rbakx/DFRobot/DFRobotInside.jpg

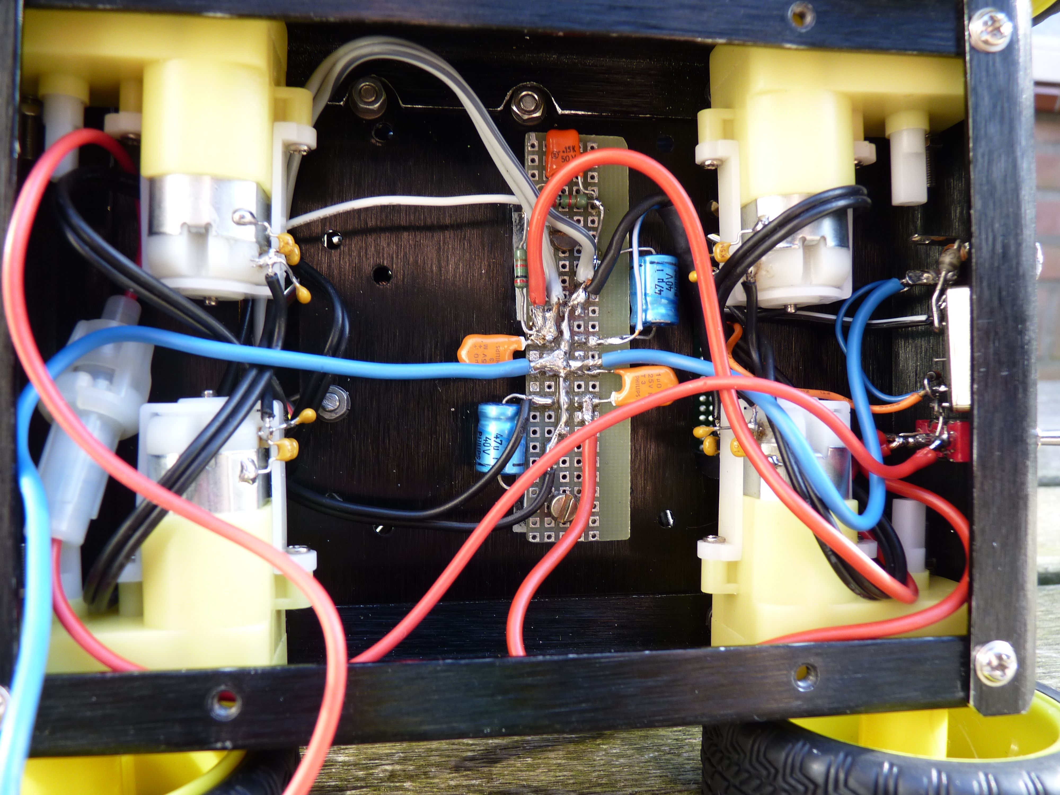
DFRobotInside.jpg
