rbakx/DFRobot/DFRobotProfilePicture.jpg

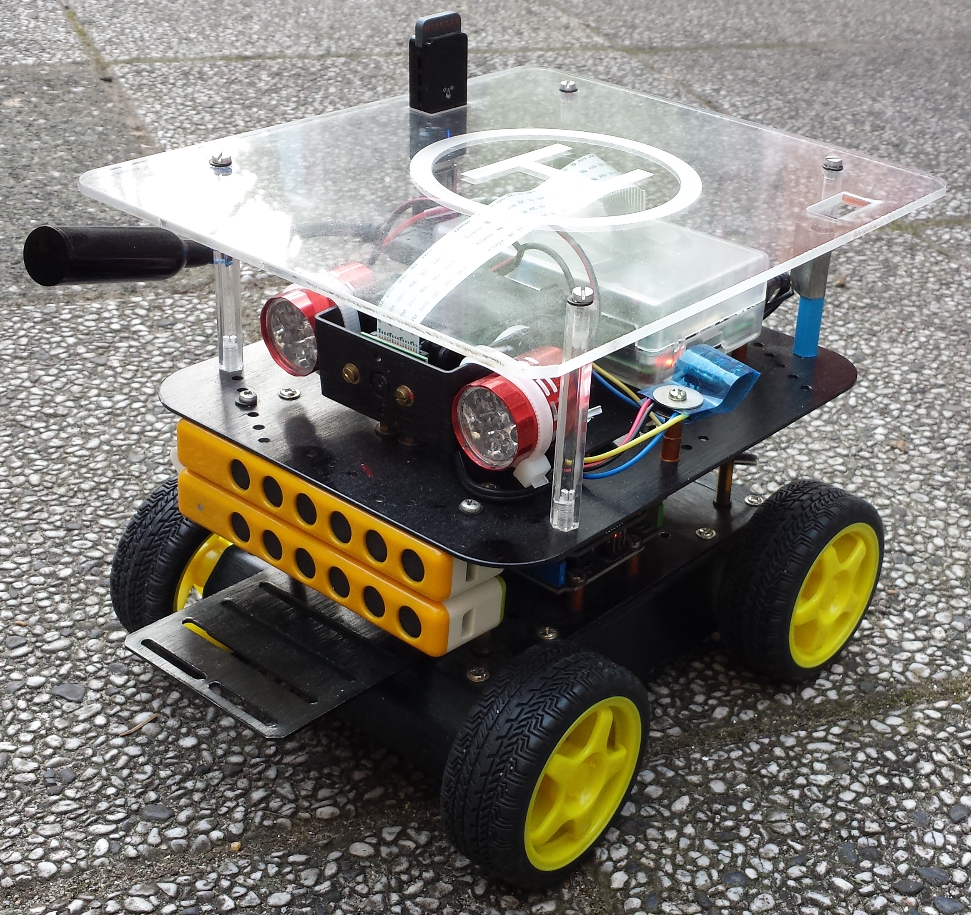
DFRobotProfilePicture.jpg
