rbakx/DFRobot/dfrobot_bw.jpg

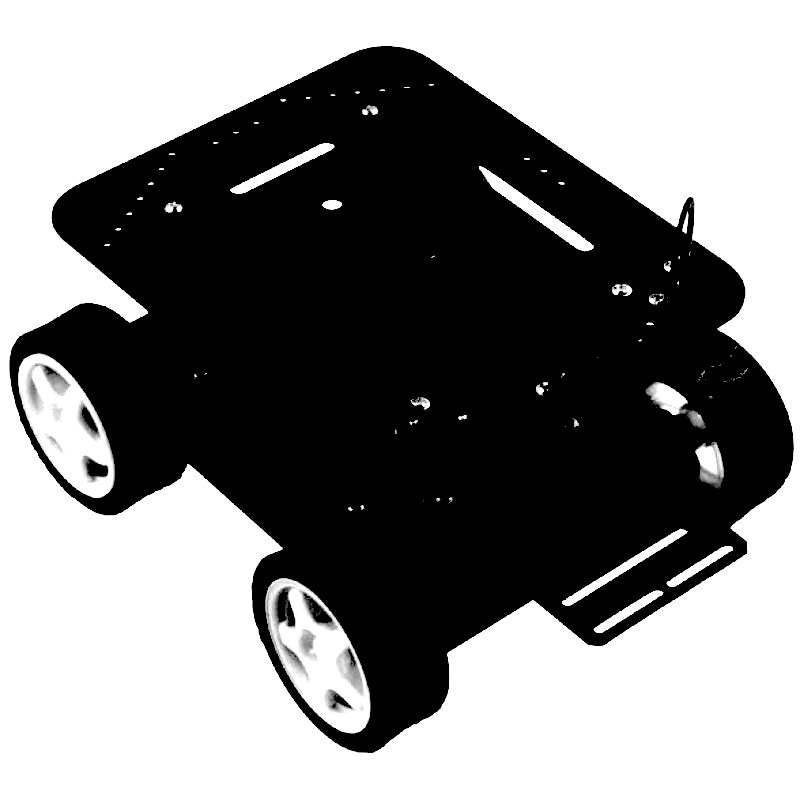
dfrobot_bw.jpg
