rbakx/DFRobot/DFRobotCircuit.png

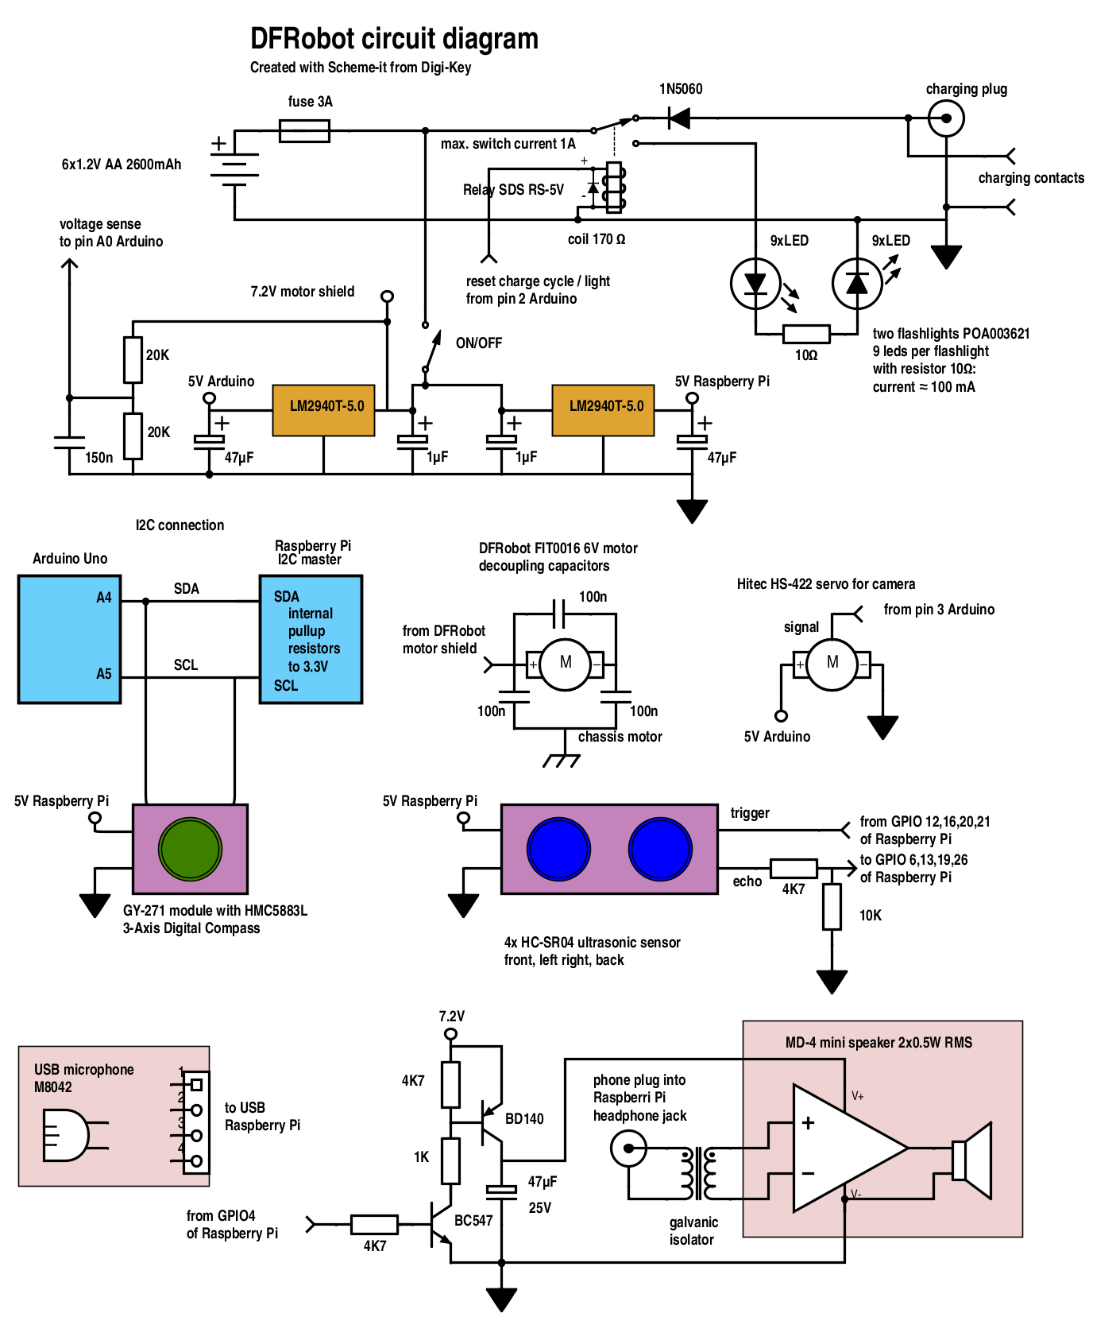
DFRobotCircuit.png
