rbakx/DFRobot/Pi/www/images/DFRobot_org.jpg

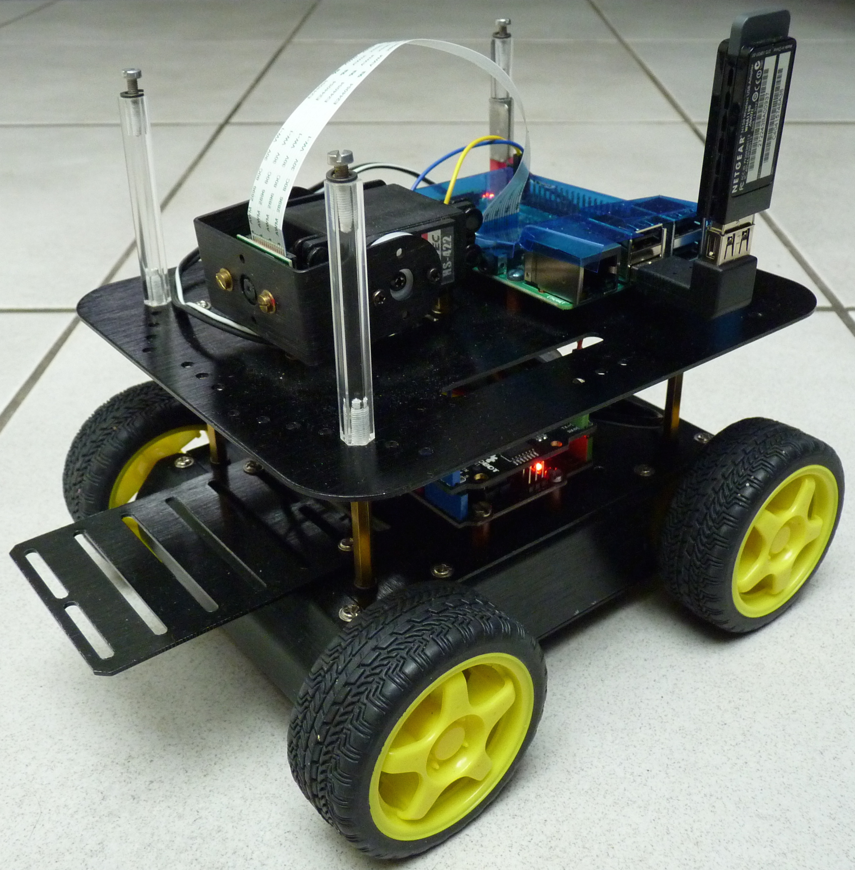
Pi/www/images/DFRobot_org.jpg
