rbakx/DFRobot/Pi/local_bin/own_util.py

#!/usr/bin/python
import time
import math
import os
import subprocess
import thread
import re
import inspect
import logging
import numpy as np
import i2c
import own_gpio


# Global variables.
slaveAddressArduino = 0x04
globUptime = 0
globExtPowerAvailable = False
globIntPowerLevel = 0
globIsCharging = False
globWifiLevel = 0
globDistance = 1000
globDoHomeRun = False
globStop = False


# runShellCommandWait(cmd) will block until 'cmd' is finished.
# This because the communicate() method is used to communicate to interact with the process through the redirected pipes.
def runShellCommandWait(cmd):
    return subprocess.Popen(cmd, stdout=subprocess.PIPE, stderr=subprocess.STDOUT, shell=True).communicate()[0]


# runShellCommandNowait(cmd) will not block because the communicate() method is not used.
# Therefore do not use 'stdout=subprocess.PIPE, stderr=subprocess.STDOUT' here as these pipes will not be read or written
# which means the process can block after a while. This happens for example when running mplayer with runShellCommandNowait().
# Therefore redirection of stdout and stderr to /dev/null is used.
def runShellCommandNowait(cmd):
    subprocess.Popen(cmd + '>/dev/null 2>&1', shell=True)


def getNofConnections():
    # Port 44444 is the main html page and port 44445 is the video stream.
    stdOutAndErr = runShellCommandWait('netstat -an | grep -E \'44444.*ESTABLISHED|44445.*ESTABLISHED\' | wc -l')
    return int(stdOutAndErr)


def isMicFree():
    # Port 44446 is the audio stream.
    stdOutAndErr = runShellCommandWait('netstat -an | grep -E \'44446.*ESTABLISHED\' | wc -l')
    if int(stdOutAndErr) == 0:
        return True
    else:
        return False


# Reboot the system.
def ownReboot(reason):
    logging.getLogger("MyLog").info('going to reboot, reason: ' + reason)
    runShellCommandNowait('sudo reboot')


# Move for a short distance. Used for safe remote control.
def move(direction, delayMove, delayAfterMove, doMove):
    if doMove:
        if direction == 'forward':
            driveAndTurn(63, 0, delayMove, 0, delayAfterMove, doMove)
        elif direction == 'backward':
            driveAndTurn(-63, 0, delayMove, 0, delayAfterMove, doMove)
        elif direction == 'left':
            driveAndTurn(0, -63, 0, delayMove, delayAfterMove, doMove)
        elif direction == 'right':
            driveAndTurn(0, 63, 0, delayMove, delayAfterMove, doMove)


# The driveAndTurn() function lets the robot drive and turn temporary or infinitely.
# When speedTurn != 0 it first drives and turns for the specified delay an then continues driving straight ahead for the specified delay.
# When speedTurn == 0 it only drives straight ahead for the specified delay.
# speedStraight: [-63..63], where [-63..-1] means backward, 0 means zero speed and [1..63] means forward.
# speedTurn:     [-63..63], where [-63..-1] means left, 0 means straight forward and [1..63] means right.
# delayDrive: [0..127], where 0 means infinite, 1 means 50 ms and 127 means 1000 ms.
# delayTurn:  [0..127], where 0 means infinite, 1 means 50 ms and 127 means 1000 ms.
# delayAfterMove is used in autonomous mode to synchronize the python script with the movements and camera stabilization of the robot.
# doMove: False to disable the actual move, for testing purposes.
def driveAndTurn(speedStraight, speedTurn, delayDrive, delayTurn, delayAfterMove, doMove):
    if doMove:
        # Create i2c lock if it does not exist yet.
        i2c.createI2cLock()
        # Lock i2c communication for this thread.
        i2c.globI2cLock.acquire()
        # I2C command 1.
        i2c.write_byte(slaveAddressArduino, 0, 1)
        # Because the I2C parameters are in the range of [128..255], speed range [-63..63] is mapped to [129..255].
        # Start with 129 to keep backward / forward or left / right symmetry around 192.
        i2c.write_byte(slaveAddressArduino, 0, int(speedStraight) + 192)
        i2c.write_byte(slaveAddressArduino, 0, int(speedTurn) + 192)
        # Because the I2C parameters are in the range of [128..255], delay range [0..127] is mapped to [128..255].
        i2c.write_byte(slaveAddressArduino, 0, int(delayDrive) + 128)
        i2c.write_byte(slaveAddressArduino, 0, int(delayTurn) + 128)
        # Delay for i2c communication.
        time.sleep(i2c.globI2cDelay)
        # Release i2c communication for this thread.
        i2c.globI2cLock.release()
    # Still delay when doMove == False to have similar timing.
    time.sleep(delayAfterMove)


def moveCamRel(degrees, delay):
    if degrees >= -90 and degrees <= 90:
        if degrees > 0:
            # Create i2c lock if it does not exist yet.
            i2c.createI2cLock()
            # Lock i2c communication for this thread.
            i2c.globI2cLock.acquire()
            # I2C command 10.
            i2c.write_byte(slaveAddressArduino, 0, 10)
            i2c.write_byte(slaveAddressArduino, 0, 128 + int(degrees))
            # Delay for i2c communication.
            time.sleep(i2c.globI2cDelay)
            # Release i2c communication for this thread.
            i2c.globI2cLock.release()
        elif degrees < 0:
            # Create i2c lock if it does not exist yet.
            i2c.createI2cLock()
            # Lock i2c communication for this thread.
            i2c.globI2cLock.acquire()
            # I2C command 11.
            i2c.write_byte(slaveAddressArduino, 0, 11)
            i2c.write_byte(slaveAddressArduino, 0, 128 - int(degrees))
            # Delay for i2c communication.
            time.sleep(i2c.globI2cDelay)
            # Release i2c communication for this thread.
            i2c.globI2cLock.release()
        # Delay to let camera image stabilize.
        time.sleep(delay)


def moveCamAbs(degrees, delay):
    if degrees >= 0 and degrees <= 90:
        # Create i2c lock if it does not exist yet.
        i2c.createI2cLock()
        # Lock i2c communication for this thread.
        i2c.globI2cLock.acquire()
        # I2C command 12.
        i2c.write_byte(slaveAddressArduino, 0, 12)
        i2c.write_byte(slaveAddressArduino, 0, 128 + int(degrees))
        # Delay for i2c communication.
        time.sleep(i2c.globI2cDelay)
        # Release i2c communication for this thread.
        i2c.globI2cLock.release()
        # Delay to let camera image stabilize.
        time.sleep(delay)


def switchLight(on):
    if on == True:
        # Create i2c lock if it does not exist yet.
        i2c.createI2cLock()
        # Lock i2c communication for this thread.
        i2c.globI2cLock.acquire()
        # I2C command 20.
        i2c.write_byte(slaveAddressArduino, 0, 20)
        # Delay for i2c communication.
        time.sleep(i2c.globI2cDelay)
        # Release i2c communication for this thread.
        i2c.globI2cLock.release()
    else:
        # Create i2c lock if it does not exist yet.
        i2c.createI2cLock()
        # Lock i2c communication for this thread.
        i2c.globI2cLock.acquire()
        # I2C command 21.
        i2c.write_byte(slaveAddressArduino, 0, 21)
        # Delay for i2c communication.
        time.sleep(i2c.globI2cDelay)
        # Release i2c communication for this thread.
        i2c.globI2cLock.release()


def updatePowerInfo():
    global globExtPowerAvailable, globIntPowerLevel
    # Create i2c lock if it does not exist yet.
    i2c.createI2cLock()
    # Lock i2c communication for this thread.
    i2c.globI2cLock.acquire()
    # Going to read I2C data.
    # Read external power level. If the level > 100, we assume external power is available.
    i2c.write_byte(slaveAddressArduino, 0, 100)  # Command to indicate a read is going to follow.
    i2c.write_byte(slaveAddressArduino, 0, 128)  # 128 means read external power level.
    if i2c.read_byte(slaveAddressArduino, 0) > 100:
        globExtPowerAvailable = True
    else:
        globExtPowerAvailable = False
    # Delay before retrieving the next power info.
    time.sleep(i2c.globI2cDelay)
    # Read internal power level. This power level can be from external power or the batteries.
    i2c.write_byte(slaveAddressArduino, 0, 100)  # Command to indicate a read is going to follow.
    i2c.write_byte(slaveAddressArduino, 0, 129)  # 129 means read internal power level.
    globIntPowerLevel = i2c.read_byte(slaveAddressArduino, 0)
    # Delay for i2c communication.
    time.sleep(i2c.globI2cDelay)
    # Release i2c communication for this thread.
    i2c.globI2cLock.release()


def updateDistanceInfo():
    global globDistance
    distance = own_gpio.getUsSensorDistance(0)
    # distance can be 0 which means invalid. In that case do not update globDistance.
    if (distance != 0):
        globDistance = distance


def updateWifiStatus():
    global globWifiLevel
    stdOutAndErr = runShellCommandWait('/sbin/iwconfig')
    # Use DOTALL (so '.' will also match a newline character) because stdOutAndErr can be multiline.
    expr = re.compile('.*ESSID:"(.*)".*?Signal level=(.*dBm)', re.DOTALL)
    m = expr.match(stdOutAndErr)
    if m is not None:  # m will be not None only when both capture groups are valid.
        globWifiLevel =  m.group(1) + ': ' + m.group(2)
    else:
        globWifiLevel = 'wifi unknown'


def updateUptime():
    global globUptime
    stdOutAndErr = runShellCommandWait('/usr/bin/uptime')
    # Use DOTALL (so '.' will also match a newline character) because stdOutAndErr can be multiline.
    expr = re.compile('.*up ([^,]+).*', re.DOTALL)
    m = expr.match(stdOutAndErr)
    if m is not None:
        globUptime = m.group(1)
    else:
        globUptime = 'unknown'


def uploadAndPurge(filepath, nrOfFilesToKeep):
    # Check if filename starts with 'dfrobot_' and number of files to keep >= 1 else do not purge anything and exit.
    filename = os.path.basename(filepath)
    if filename[:8] != 'dfrobot_' or nrOfFilesToKeep < 1:
        logging.getLogger("MyLog").info('uploadAndPurge: illegal filepath:nrOfFilesToKeep to upload and purge: ' + filepath + ':' + str(nrOfFilesToKeep))
        return
    
    # Going to upload the file to Google Drive using the 'drive' utility.
    # To upload into the 'DFRobotUploads' folder, the -p option is used with the id of this folder.
    # When the 'DFRobotUploads' folder is changed, a new id has to be provided.
    # This id can be obtained using 'drive list -t DFRobotUploads'.
    # The uploaded file has a distinctive name to enable finding and removing it again with the 'drive' utility.
    logging.getLogger("MyLog").info('going to call \'drive\' to upload ' + filepath)
    # Run 'drive' as www-data to prevent Google Drive authentication problems.
    stdOutAndErr = runShellCommandWait('sudo -u www-data /usr/local/bin/drive upload -p 0B1WIoyfCgifmMUwwcXNqeDl6U1k -f ' + filepath)
    logging.getLogger("MyLog").info(stdOutAndErr)

    # Purge filename on Google Drive to prevent filling up.
    logging.getLogger("MyLog").info('going to purge ' + filename)
    # Find all Id's of filename versions on drive.
    stdOutAndErr = runShellCommandWait('sudo -u www-data /usr/local/bin/drive list -t ' + filename)
    # Now stdOutAndErr is a multiline string containing on each line a file version.
    # The last line is the oldest.
    # The first line is the title line so does not contain a valid file version.

    # Use a regular expression to get the file Id's of the oldest files to be purged in a list.
    # Use MULTILINE (so '^' will match the start of a new line) because stdOutAndErr can be multiline.
    expr = re.compile('(^.*?) ', re.MULTILINE)
    idList = expr.findall(stdOutAndErr)
    # Now idList is a list containing the Id's of all file versions.
    # The last Id in the list is the oldest.
    if idList is not None:
        logging.getLogger("MyLog").info('uploadAndPurge: ' + str(len(idList) - 1) + ' versions of ' + filename + ' found on Google Drive')
        # Iterate backwards through the list, starting with the oldest file
        # until there are nrOfFilesToKeep files left.
        for i in range(len(idList)-1, nrOfFilesToKeep, -1):
            # Delete this file version.
            stdOutAndErr = runShellCommandWait('sudo -u www-data /usr/local/bin/drive delete -i ' + idList[i])
            logging.getLogger("MyLog").info(stdOutAndErr)
