rbakx/DFRobot/(commit log)

2015-01-22 Added camera module installation instructions
2015-01-29 Updated Pi camera MJPG streamer instructions
2015-02-03 Added intro to doc and aded vertical flip -vf to camera
2015-02-04 Streaming MJPEG and fixed refresh
    Switched from JavaScript supported MJPEG to browser supported MJPEG,
    which is about 3 times faster.
    Fixed CGI Python refresh issue of webpage.
2015-02-05 switch from Python CGI to bash CGI
    Because Python CGI is very slow (1 to 3 seconds for each POST) I
    switched from Python CGI to bash CGI.
2015-02-06 removed while loop from dfrobot.sh
    Removed the original while loop from dfrobot.sh which was originally
    taken from
    http://tuxx-home.at/cmt.php?article=/2005/06/17/T09_07_39/index.html
    but in this case has no added value.
2015-02-20 Added Arduino code and I2C connection to Pi
    This is the first version of the DFRobot project where the robot can be
    controlled from the webpage: forward, backward, left and right!
2015-02-20 Added battery status and light
2015-02-20 Added sd card mounting instructions
    Added sd card mounting instructions and also added extra Wifi access
    point to allow roaming.
2015-02-21 Added extra status frame and security
    Added extra status html frame to only refresh the status when needed.
    Added Apache password protection of the DFRobot web page.
2015-02-21 changed charge cycle from 6 to 2 hrs
2015-04-08 Updated watchdog info and added circuit diagram
2015-04-19 Added camera servo control up and down
2015-04-19 Updated naming to support multiple servos
2015-04-26 Uodated circuit diagram and bigger status area.
    Updated circuit diagram with charging contacts. Also enlarged status
    area on html page to support more status text.
2015-04-26 Servo for camera to pin 3 and added to drawing
2015-05-03 Added automated uploads to Google Drive and more...
    - Added automated uploads of captured H264 video to Google Drive using
    the ‘drive’ utility.
    - Added purging of these automated video so Google Drive does not fill
    up.
    - Added a runDFRobot script and scheduled it with ‘cron’ to capture
    H264 and upload to Google Drive every hour!
    - When an user is connected to the webwerver the runDFRobot script does
    not initiate any action.
2015-05-14 switched to use of uv4l for video, better support and performance
2015-05-14 changed video framerate from 30 to 10 for better performance when connection is poor
2015-05-14 updated doc for framerate 30 -> 10
2015-05-15 Added low video framerate measurement
2015-07-19 Installed OpenCV from standard package and switched back from UV4L to mjpg-streamer
2015-07-24 Raspberry B+ replaced by Raspberry 2B, increase of openCV screen resolution and added compass script.
    [compass.py]
2015-07-28 Switch from findContours to SimpleBlobDetector 'for better performance (color independent)
2015-07-28 run_dfrobot.py uses blob detector to find back the garage.
    goHomeDFRobot.py and runDFRobot.py are replaced by one script:
    run_dfrobot.py.
    This script can run in the Full run or in the Home run mode.
    It uses cv2.SimpleBlobDetector() to find the garage and connect to the
    charging station.
    [compass.py, dfrobot.ino, own_util.py, run_dfrobot.py]
2015-07-30 updated circuit diagram and added delay in compass.py
2015-07-30 new calibration compass HMC5883L
2015-08-16 Implemented separate video thread and motion detection
2015-08-17 In homerun blob detection skip blobs which are significantly smaller than the other blobs
    [run_dfrobot.py]
2015-08-22 separate thread for WhatsApp client for handling incoming and outgoing messages
    whatsAppClient() is now a separate thread handling incoming and
    outgoing messages.
    Commands can be given via WhatsApp like sending a picture, report
    battery level.
2015-08-22 Replaced own logging by Python logging and solved locking up problems
    [own_util.py, run_dfrobot.py]
2015-08-22 Make use of Python shutil functions and solved potential lock
    [run_dfrobot.py]
2015-08-23 Solved one more locking issue.
    [own_util.py, run_dfrobot.py]
2015-08-23 Added restart of whatsAppClient if needed
    the yowsup-cli seems not very stable, so we catch the exception if the
    stdin pipe to if it is broken (due to a crash of yowsup-cli) and
    restart.
    [own_util.py, run_dfrobot.py]
2015-09-01 WhatsApp message handling is now done in whatsAppClient() instead of in motionDetection()
    WhatsApp message handling is now done in whatsAppClient() instead of in
    motionDetection() because the whatsAppClient() thread always runs.
2015-09-03 Added checkWhatsAppClient() to check and restart whatsAppClient thread if needed
2015-09-08 Fixed validBlobsFound bug and added battery charging status
    [compass.py, own_util.py, run_dfrobot.py]
2015-09-13 Smarter argument parsing and check charging status in whatsApp thread
2015-09-13 reduced number of calibration rounds
2015-09-13 Added offset correction at 180 degrees for the compass
    [compass.py]
2015-09-20 Added socket connection between cgi bash script and python
2015-09-26 Replaced purge_dfrobot_uploads.sh by Python function uploadAndPurge()
    [own_util.py]
2015-09-27 Two way socket communication and no need anymore to check number of connections for detecting webpage activity.
2015-10-18 replaced i2c_cmd by Python script
    [communication.py, compass.py, i2c.py, own_util.py, run_dfrobot.py]
2015-10-20 Adapted circuit diagram to new flashlights wit series resistor.
2015-10-21 Fixed I2C communication problem by adding exception handling
    Occasionally the I2C communication between the Raspberry and the
    Arduino gave a ‘[Errno 5] Input/output error’. This seems to be a known
    problem. Adding exception handling for I2C communication prevents the
    code from crashing.
    [compass.py, i2c.py, own_util.py]
2015-10-21 Added /boot/config.txt with custom i2c settings
    [config.txt]
2015-10-24 Added charging status on website and added SD card images list to DFRobot document
2015-10-30 Fixed WhatsApp authorization error by re-registering and running Yowsup setup.
    [communication.py, run_dfrobot.py]
2015-11-22 Added personal assistant!
    [config.txt]
2015-11-22 name of personal assistant changed from robbie to james
    [communication.py]
2015-11-25 Improved clap detection and automatic switch on lights when dark.
2015-12-02 Improved recognition of alarm voice command, fix of runShellCommandNowait() problem with mplayer
    [own_util.py, personal_assistant.py]
2015-12-12 Added bandpass filter to improve clapping detection and added Ibm speech recognition for when Google is offline
2015-12-12 Improved clap detection by using bandpass filter and added support for IBM Watson and Wit.ai speech engines
2015-12-15 fixed 'list index out of range' problem when there is no speech (silence) sent to Google
    [personal_assistant.py]
2016-01-01 Updated info on Raspberry Pi firmware
2016-01-02 Added more info on Raspberry Pi boot process.
2016-04-27 Bind socket to any host so robot can be controlled by any host.
2016-04-28 Added 'James go home' voice command.
    [personal_assistant.py]
2016-05-01 Socket connection from TCP to UDP, added ultrasonic sensor and Unity support through socket
2016-05-17 Enabled text box command window and added reboot command
    [compass.py, own_util.py, run_dfrobot.py]
2016-07-30 More robust reboot and added 'whatsapp' command to restart WhatsApp
    • Moved handling of ‘reboot’ command from run_dfrobot.py to dfrobot.sh
    to make sure it is executed; other threads might be corrupt.
    • Fixed ‘globBrightness’ bug in run_dfrobot.py so lights are not always
    switched on after the ‘home-start’ command.
    • Added 3 seconds delay in ‘startWhatsAppClient()’ to make sure
    WhatsApp connects after a reboot.
    • Added ‘whatsapp’ command to restart WhatsApp if needed.
    [communication.py, run_dfrobot.py]
2016-09-18 Replaced WhatsApp by Telegram.
    • Run of sudo apt-get update and sudo apt-get upgrade to upgrade all
    installed Wheezy packages.
    • Cleaned downloaded packages with sudo apt-get clean.
    • Replaced WhatsApp by Telegram.
    • Upload to Google Drive commented out and replaced by sending to
    Telegram.
    [communication.py, run_dfrobot.py]
2016-11-26 Added Mic button on webpage to start streaming
2016-11-26 Simpler audio streaming switching and 16 KHz
2017-05-22 Fixed driving and turning in FPV mode
    [communication.py, dfrobot.ino, own_util.py, run_dfrobot.py]
2017-05-28 Replaced CGI by websocket communication
    [communication.py, compass.py, own_util.py, personal_assistant.py, run_dfrobot.py]
2017-07-03 updated mjpg-streamer to solve broken pipe issues
    [communication.py, run_dfrobot.py]
2017-07-16 Moved back to Pi camera and added external power switch
    • Reverted back to use of Raspberry Pi camera as the PU` Aimetis Dual
    Lens USB Camera is broken.
    • Added switching to external power when it is available. This is done
    using a relay. Switching from batteries to external power is when the
    robot is in the garage and only when the external power is stable.
    Switching from external power to batteries is done just before the
    robot starts driving out of the garage. This because during the power
    switch the robot is powered only by a capacitor so the robot cannot
    drive during the switch.
    Status of robot on webpage now indicates whether power is coming from
    external or from batteries.
    [communication.py, dfrobot.ino, own_util.py, run_dfrobot.py]
2017-07-17 Calibrated compass and switch off light relay when using compass because its magnetic field influences the compass!
2017-07-17 Changed switching time to external power to 10 seconds to give robot time to park properly in the garage
2017-07-23 Added 1000 µF capacitor in circuit diagram
2017-07-27 updated circuit diagram with new flashlights
